honzup/LCC_Interface_KiCad/images/board_bottom.png

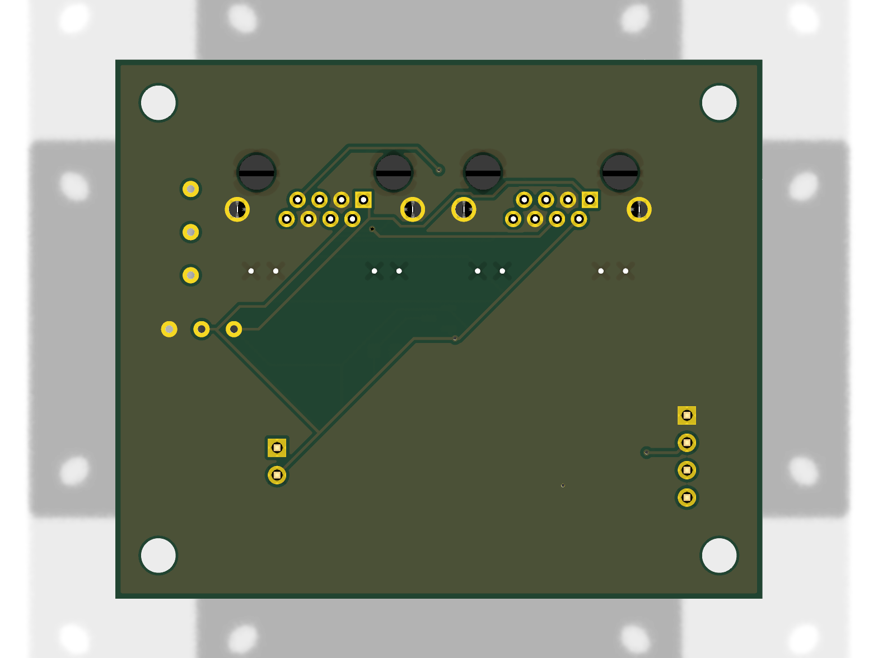
images/board_bottom.png
