honzup/LCC_Interface_KiCad/BOM.csv

Reference | Qty | Value | Footprint | Manufacturer Part | DigiKey Part | Notes
U1 | 1 | TCAN332DR | Package_SO:SOIC-8 | TCAN332DR (TI) | 296-43711-1-ND | 3.3V CAN transceiver (Cut Tape); footprint also fits TCAN330/334/337 (see R2/R3); alt TCAN332GDR
C1 | 1 | 100nF 50V X7R | C_0805 | CL21B104KBCNNNC (Samsung) or equiv | 1276-1006-1-ND | VCC decoupling; GENERIC - any 100nF X7R 0805 works
C2 | 1 | 4.7uF 16V X7R | C_0805 | any 4.7uF 16V+ X7R 0805 | search by spec | VCC bulk; GENERIC - Samsung CL21B475KO../Murata/TDK all fine; exact suffix does not matter
R1 | 1 | 120R 1% | R_0805 | RC0805FR-07120RL (Yageo) | 311-120CRCT-ND | Bus termination (conducts only when JP1 fitted)
R2 | 1 | 10k | R_0805 | RC0805FR-0710KL (Yageo) | 311-10.0KCRCT-ND | DNP - fit only for TCAN330/334/337 (pin 5 low)
R3 | 1 | 10k | R_0805 | RC0805FR-0710KL (Yageo) | 311-10.0KCRCT-ND | DNP - fit only for TCAN330/334/337 (pin 8 low)
D1 | 1 | PESD1CAN | Package_TO_SOT_SMD:SOT-23 | PESD1CAN,215 (Nexperia) | 568-4032-1-ND | CAN-bus ESD/TVS (Cut Tape); NOT PESD1CANVL / -UX
JP1 | 1 | 2-pin header 2.54mm | PinHeader_1x02 | PRPC040SAAN-RC (Sullins) | S1011EC-40-ND | Termination enable jumper (snap from strip)
J1 | 1 | RJ45 shielded | Connector_RJ:RJ45_Amphenol_RJHSE5380-08 | RJHSE-5380 (Amphenol ICC) | RJHSE-5380-ND | LCC bus - NOT Ethernet; NOT -5385 (LED variant); shell to CAN_GND
J2 | 1 | RJ45 shielded | Connector_RJ:RJ45_Amphenol_RJHSE5380-08 | RJHSE-5380 (Amphenol ICC) | RJHSE-5380-ND | LCC bus daisy-chain pass-through
J3 | 1 | 1x4 header 2.54mm | PinHeader_1x04 | PRPC040SAAN-RC (Sullins) | S1011EC-40-ND | MCU: 1=GND 2=3V3 3=TX 4=RX (snap from strip)
D2 | 1 | LED 0805 | LED_SMD:LED_0805_2012Metric | LTST-C170KGKT (Lite-On) or equiv | 160-1414-1-ND | Rev C power indicator: +3V3 -> R4 -> D2 -> CAN_GND; GENERIC - any 0805 LED, colour to taste
D3 | 1 | LED 0805 | LED_SMD:LED_0805_2012Metric | LTST-C170KGKT (Lite-On) or equiv | 160-1414-1-ND | Rev C TX activity: +3V3 -> R5 -> D3 anode, cathode -> CAN_TX (blinks on transmit); ~1-2 mA
D4 | 1 | LED 0805 | LED_SMD:LED_0805_2012Metric | LTST-C170KGKT (Lite-On) or equiv | 160-1414-1-ND | Rev C RX activity: +3V3 -> R6 -> D4 anode, cathode -> CAN_RX; ~1-2 mA
R4 | 1 | 1k | R_0805 | RC0805FR-071KL (Yageo) | 311-1.0KCRCT-ND | Rev C - D2 power-LED series resistor (1k = deliberately low current ~1-2 mA @ 3.3V)
R5 | 1 | 1k | R_0805 | RC0805FR-071KL (Yageo) | 311-1.0KCRCT-ND | Rev C - D3 TX-LED series resistor (1k)
R6 | 1 | 1k | R_0805 | RC0805FR-071KL (Yageo) | 311-1.0KCRCT-ND | Rev C - D4 RX-LED series resistor (1k)
TP1 TP2 TP3 TP4 TP5 TP6 | 6 | Test point (optional) | TestPoint_THT | 5015 (Keystone) | 36-5015-ND | Optional loops - bare pads work; CAN_H / CAN_L / CAN_GND / +3V3 / CAN_TX / CAN_RX (Rev C added TP4-6)
