honzup/LCC_Interface_KiCad/LCC_Interface.kicad_pcb

## KiCad design LCC_Interface.kicad_pcb (2026-09-22)

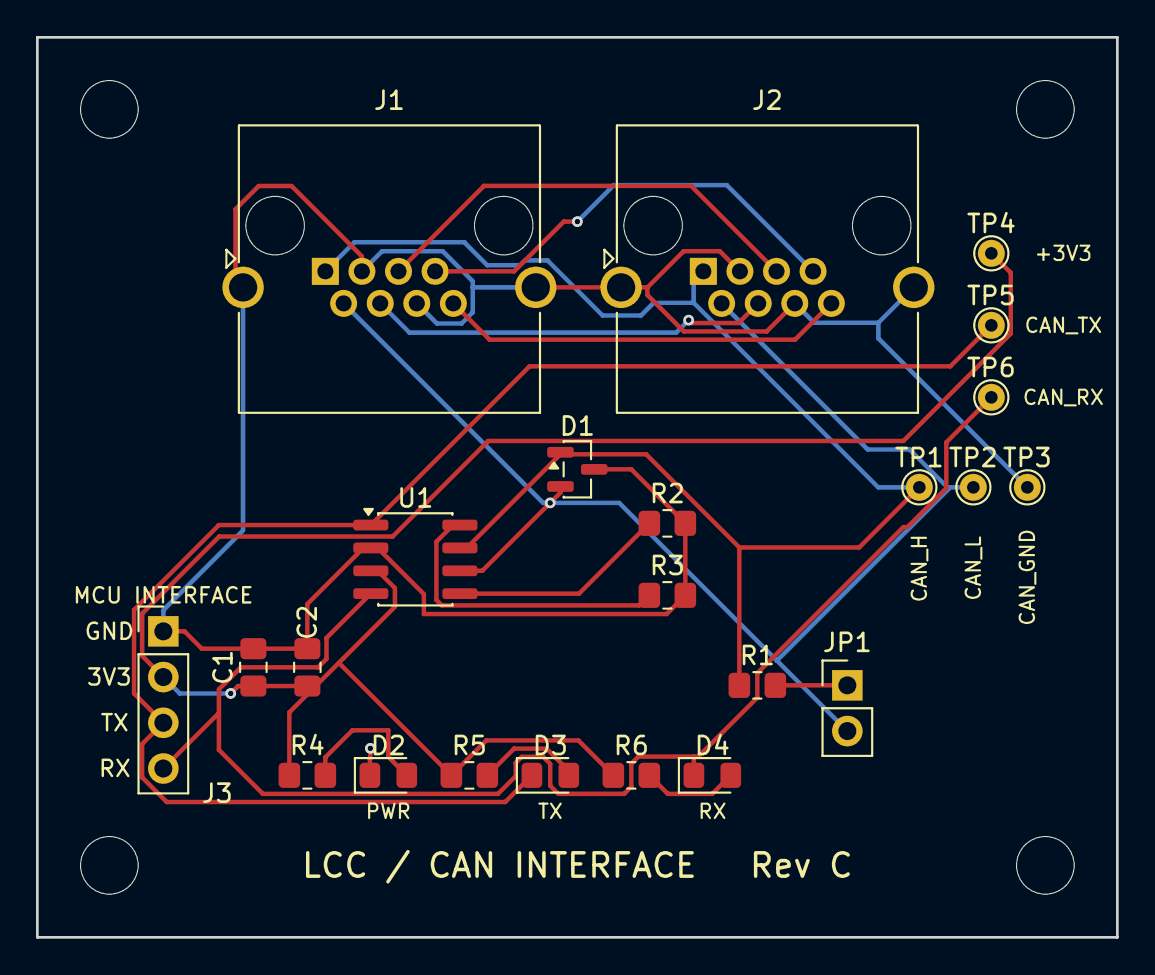
[picture p3: board LCC_Interface.kicad_pcb from above]

Board: 2 copper layers, 60.0 x 50.0 mm, 27 parts (0 on the bottom side), 16 nets.

Parts:
C1: 100nF; C_0805_2012Metric_Pad1.18x1.45mm_HandSolder
C2: 4.7uF; C_0805_2012Metric_Pad1.18x1.45mm_HandSolder
D1: PESD1CAN; SOT-23
D2, D3, D4: LED; LED_0805_2012Metric_Pad1.15x1.40mm_HandSolder
H1, H2, H3, H4: MountingHole_3.2mm_M3
J1, J2: LCC RJ45; RJ45_Amphenol_RJHSE5380
J3: MCU INTERFACE; PinHeader_1x04_P2.54mm_Vertical
JP1: TERM ENABLE; PinHeader_1x02_P2.54mm_Vertical
R1: 120R; R_0805_2012Metric_Pad1.20x1.40mm_HandSolder
R2, R3: 10k DNP; R_0805_2012Metric_Pad1.20x1.40mm_HandSolder
R4, R5, R6: 1k; R_0805_2012Metric_Pad1.20x1.40mm_HandSolder
TP1, TP2, TP3, TP4, TP5, TP6: TP; TestPoint_THTPad_D1.5mm_Drill0.7mm
U1: TCAN332DR; SOIC-8_3.9x4.9mm_P1.27mm

Connections:
/+3V3: C1.1, C2.1, J3.2, R4.1, R5.1, R6.1, TP4.1, U1.3
/ALT_H: J1.5, J2.5
/ALT_L: J1.4, J2.4
/CAN_GND: C1.2, C2.2, D1.3, D2.1, J1.3, J1.6, J1.SH, J2.3, J2.6, J2.SH, J3.1, R2.2, R3.2, TP3.1, U1.2
/CAN_H: D1.1, J1.1, J2.1, R1.1, TP1.1, U1.7
/CAN_L: D1.2, J1.2, J2.2, JP1.2, TP2.1, U1.6
/CAN_RX: D4.1, J3.4, TP6.1, U1.4
/CAN_TX: D3.1, J3.3, TP5.1, U1.1
/LED_PWR: D2.2, R4.2
/LED_RX: D4.2, R6.2
/LED_TX: D3.2, R5.2
/MODE5: R2.1, U1.5
/MODE8: R3.1, U1.8
/PWR_NEG: J1.7, J2.7
/PWR_POS: J1.8, J2.8
/TERM_MID: JP1.1, R1.2
