honzup/LCC_Interface_KiCad/(commit log)

2026-09-19 Add LCC/CAN interface KiCad project (Rev B)
    Includes RJ45 J1/J2 3D-model path fix (RJHSE5380 -> RJHSE538X).
    [BOM.csv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]
2026-09-22 Add Rev C: diagnostic LEDs/test points, RJ45 models, Gerbers
    [BOM.csv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]
2026-09-22 Repoint build pipeline to system KiCad 10.0.6
2026-09-22 Fix build_place.py for 10.0.6: FPDIR, RJ45 footprint + 3D model
2026-09-22 Update BOM RJ45 footprint name to 10.0.6 library (-08)
    [BOM.csv]
2026-10-21 Save project settings from KiCad 10.0.6
2026-10-21 Rewrite README for public readers, keep only Rev C files, add licence
    [LCC_Interface-B_Cu.gbl, LCC_Interface-B_Mask.gbs, LCC_Interface-B_Paste.gbp, LCC_Interface-B_Silkscreen.gbo, LCC_Interface-Edge_Cuts.gm1, LCC_Interface-F_Cu.gtl, LCC_Interface-F_Mask.gts, LCC_Interface-F_Paste.gtp]
